vasuul/rgbw_lamp_hw/RGBEncoder-PIC18/RGBEncoder-PIC18.kicad_pcb

## KiCad design RGBEncoder-PIC18/RGBEncoder-PIC18.kicad_pcb (2018-02-17)

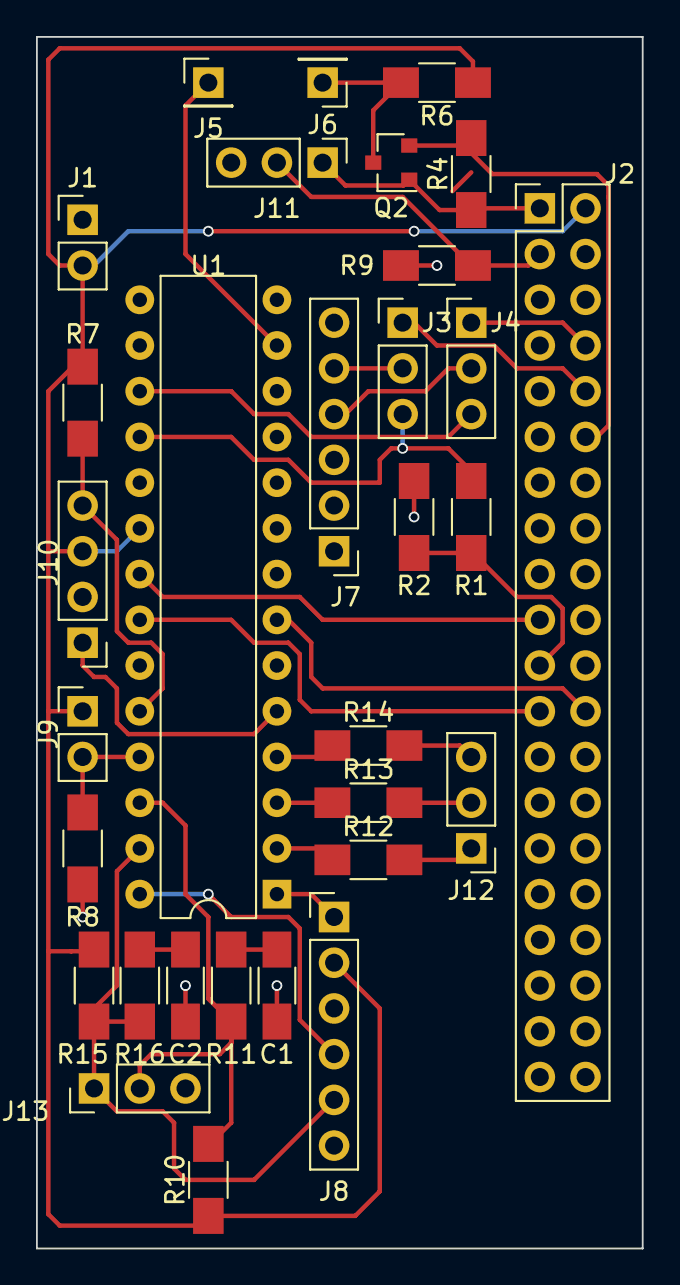
[picture p1: board RGBEncoder-PIC18.kicad_pcb from above]

Board: 2 copper layers, 33.7 x 67.3 mm, 31 parts (0 on the bottom side), 32 nets.

Parts:
C1, C2: .01uF; C_1206_HandSoldering
J1: Power +5V; Pin_Header_Straight_1x02_Pitch2.54mm
J2: Raspberry_Pi_2_3; Pin_Header_Straight_2x20_Pitch2.54mm
J3: SerialRX; Pin_Header_Straight_1x03_Pitch2.54mm
J4: SerialTX; Pin_Header_Straight_1x03_Pitch2.54mm
J5: FanOn; Pin_Header_Straight_1x01_Pitch2.54mm
J6: LightStrip; Pin_Header_Straight_1x01_Pitch2.54mm
J7: SerialComm; Pin_Header_Straight_1x06_Pitch2.54mm
J8: PICKit; Pin_Header_Straight_1x06_Pitch2.54mm
J9: EncoderBtn; Pin_Header_Straight_1x02_Pitch2.54mm
J10: FrontButton; Pin_Header_Straight_1x04_Pitch2.54mm
J11: TempSensor; Pin_Header_Straight_1x03_Pitch2.54mm
J12: EncoderLED; Pin_Header_Straight_1x03_Pitch2.54mm
J13: EncoderEnc; Pin_Header_Straight_1x03_Pitch2.54mm
Q2: BSS138; SOT-23
R1, R12: 330; R_1206_HandSoldering
R2: 660; R_1206_HandSoldering
R4, R6, R7, R8, R9, R10, R11, R15, R16: 10K; R_1206_HandSoldering
R13, R14: 220; R_1206_HandSoldering
U1: PIC18F2550-ISP; DIP-28_W7.62mm

Connections:
+3V3: J2.1, J11.1, Q2.1, R4.1
+5V: J1.2, J2.2, J8.2, J9.1, J10.3, R6.1, R7.2, R10.1, R15.1, U1.20
/ENC_A: J8.5, J13.1, R15.2, R16.1, U1.27
/ENC_B: J13.2, R10.2, R11.1, U1.26
/ENC_BTN: J9.2, R8.1, U1.25
/ENC_LED_B: R14.1, U1.4
/ENC_LED_G: R13.1, U1.3
/ENC_LED_R: R12.1, U1.2
/FAN_IN: J5.1, U1.13
/FBTN: J10.4, R7.1, U1.24
/FB_CATH: J10.1, U1.5
/MISO: J2.21, R1.1, R2.1
/MOSI: J2.19, U1.21
/PGD: J8.4, U1.28
/PIC_RX: J3.3, R1.2, U1.18
/PIC_TX: J4.3, U1.17
/RPI_RX: J2.10, J3.1
/RPI_TX: J2.8, J4.1
/SCLK: J2.23, U1.22
/SER_RX: J3.2, J7.5
/SER_TX: J4.2, J7.4
/STRIP_OUT: J2.12, Q2.2, R4.2
/TEMP_IN: J2.3, J11.2, R9.2
/VPP/_MCLR: J8.1, U1.1
/_CE0: J2.24, U1.7
GND: C1.2, C2.2, J1.1, J2.6, J2.9, J2.14, J2.20, J2.25, J2.30, J2.34, J2.39, J7.1, J8.3, J10.2, J11.3, J13.3, R2.2, R8.2, R9.1, U1.8, U1.19
unnamed: C1.1, R11.2
unnamed: C2.1, R16.2
unnamed: J6.1, Q2.3, R6.2
unnamed: J12.1, R12.2
unnamed: J12.2, R13.2
unnamed: J12.3, R14.2
