vasuul/rgbw_lamp_hw/(commit log)

2018-02-17 Front button presses only sent on status command. Sending 0 for front button led now turns it off.
2018-02-17 Added KiCad hw files including board and schematic.
    [RGBEncoder-PIC18.kicad_pcb, RGBEncoder-PIC18.sch]
